2201102/STMC071_board/production/bom.csv

Designator | Footprint | Quantity | Value | LCSC Part #
C1 | 0603 | 1 | 0.1uF
C2 | 0805 | 1 | 10uF | C96446
C3 | 1206 | 1 | 22uF | C45783
C4 | 0603 | 1 | 100nF | C14663
D1 | SOT-23-3 | 1 | CH213K
D2, D3, D4, D5, D6, D7 | LED_WS2812B_PLCC4_5.0x5.0mm_P3.2mm | 6 | WS2812B
D8 | 0805 | 1 | LED_Y | C2296
J1 | U2CF8PA_USB_C | 1 | USB_C_Receptacle_USB2.0_14P
J2 | PinHeader_1x04_P2.54mm_Vertical | 1 | Conn_01x04_Pin
J3, J4 | PinHeader_1x10_P2.54mm_Vertical | 2 | Conn_01x10_Pin
R1, R2 | R_Axial_DIN0207_L6.3mm_D2.5mm_P7.62mm_Horizontal | 2 | 5.1k | C23186
R3 | 0603 | 1 | 1k | C22787
R4 | 0603 | 1 | 10k | C25804
SW1, SW2, SW3 | TS3315 | 3 | SW_Push | C720477
U2 | TSSOP-20_4.4x6.5mm_P0.65mm | 1 | STM32C071F8Px
U3 | SOT-23-3 | 1 | SLHT33H | MCP1700T-3302E/TT
