2201102/STMC071_board/STM32C071.kicad_pcb

## KiCad design STM32C071.kicad_pcb (2026-09-05)

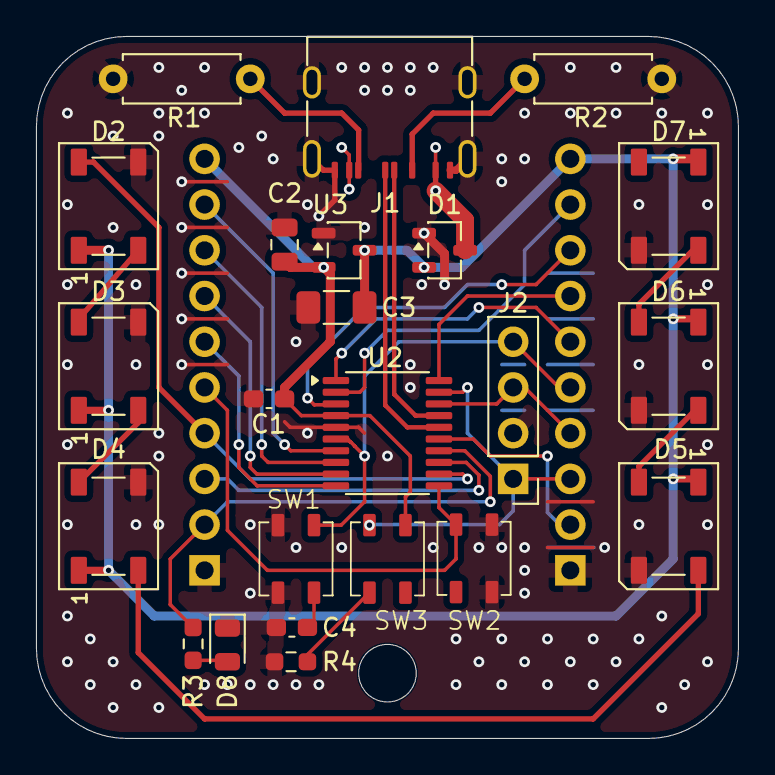
[picture p5: board STM32C071.kicad_pcb from above]

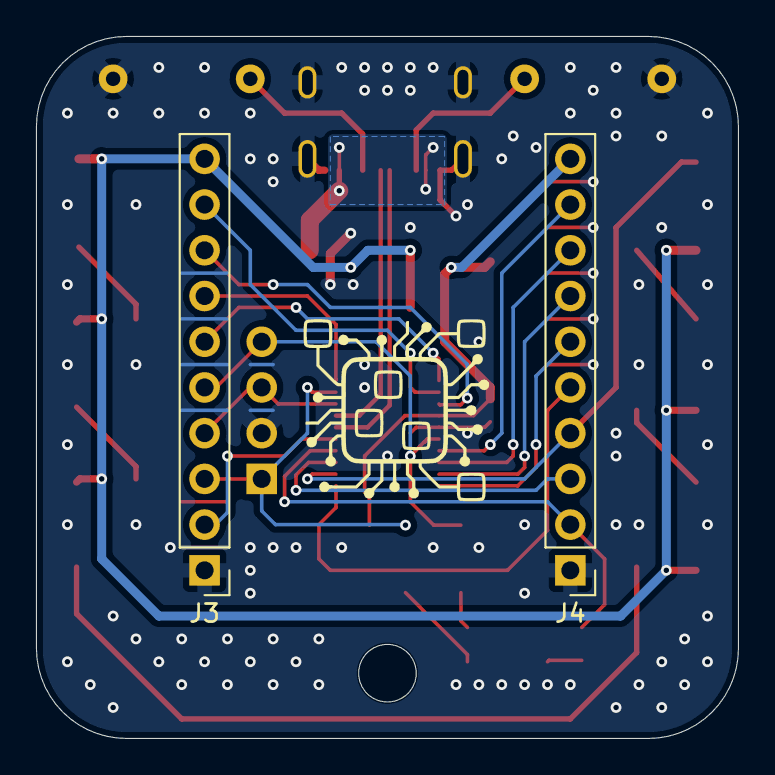
[picture p6: board STM32C071.kicad_pcb from below]

Board: 2 copper layers, 39.0 x 39.0 mm, 26 parts (2 on the bottom side), 30 nets.

Parts:
C1: 0.1uF; C_0603_1608Metric_Pad1.08x0.95mm_HandSolder
C2: 10uF; C_0805_2012Metric
C3: 22uF; C_1206_3216Metric_Pad1.33x1.80mm_HandSolder
C4: 100nF; C_0603_1608Metric_Pad1.08x0.95mm_HandSolder
D1: CH213K; SOT-23-3
D2, D3, D4, D5, D6, D7: WS2812B; LED_WS2812B_PLCC4_5.0x5.0mm_P3.2mm
D8: LED_Y; LED_0805_2012Metric
H1: MountingHole; MountingHole_3.2mm_M3
J1: USB_C_Receptacle_USB2.0_14P; U2CF8PA_USB_C
J2: Conn_01x04_Pin; PinHeader_1x04_P2.54mm_Vertical
J3, J4: Conn_01x10_Pin; PinHeader_1x10_P2.54mm_Vertical
R1, R2: 5.1k; R_Axial_DIN0207_L6.3mm_D2.5mm_P7.62mm_Horizontal
R3: 1k; R_0603_1608Metric_Pad0.98x0.95mm_HandSolder
R4: 10k; R_0603_1608Metric_Pad0.98x0.95mm_HandSolder
SW1, SW2, SW3: SW_Push; TS3315
U2: STM32C071F8Px; TSSOP-20_4.4x6.5mm_P0.65mm
U3: SLHT33H; SOT-23-3

Connections:
+3V3: C1.1, C2.1, J4.10, SW3.1, U2.4 (VDD), U3.2 (OUT)
+5V: C3.1, D1.2 (VO-), D2.1 (VDD), D3.1 (VDD), D4.1 (VDD), D5.1 (VDD), D6.1 (VDD), D7.1 (VDD), J3.10, U3.3 (IN)
/PA0: J4.9, U2.7 (PA0)
/PA1: J4.8, U2.8 (PA1)
/PA2: J4.7, U2.9 (PA2)
/PA3: J4.6, U2.10 (PA3)
/PA6: J4.3, U2.13 (PA6)
/PA8: J3.2, U2.15 (PA8)
/PB3/PB4/PB5/PB6: J3.7, U2.20 (PB3/PB4/PB5/PB6)
/PB7/PB8: J3.6, U2.1 (PB7/PB8)
/PC14: J3.9, U2.2 (PC14)
/PC15: J3.8, U2.3 (PC15)
GND: C1.2, C2.2, C3.2, C4.2, D1.1 (GND), D2.3 (VSS), D3.3 (VSS), D4.3 (VSS), D5.3 (VSS), D6.3 (VSS), D7.3 (VSS), D8.1 (K), J1.A12 (GND), J1.B12 (GND), J1.SH (SHIELD), J2.2, J3.1, J4.1, R1.1, R2.1, R4.2, SW1.2, SW2.2, U2.5 (VSS), U3.1 (GND)
NRST: C4.1, J2.4, J3.5, SW1.1, U2.6 (PF2)
Neopixel: D2.4 (DIN), J4.4, U2.12 (PA5)
unnamed: D1.3 (VI+), J1.A9 (VBUS), J1.B9 (VBUS)
unnamed: D2.2 (DOUT), D3.4 (DIN)
unnamed: D3.2 (DOUT), D4.4 (DIN)
unnamed: D4.2 (DOUT), D5.4 (DIN)
unnamed: D5.2 (DOUT), D6.4 (DIN)
unnamed: D6.2 (DOUT), D7.4 (DIN)
unnamed: D8.2 (A), R3.2
unnamed: J1.A5 (CC1), R2.2
unnamed: J1.B5 (CC2), R1.2
T_SWCLK: J2.1, J3.3, R4.1, SW3.2, U2.19 (PA14/PA15)
T_SWDIO: J2.3, J3.4, U2.18 (PA13)
USB_D+: J1.A6 (D+), U2.17 (PA12)
USB_D-: J1.A7 (D-), U2.16 (PA11)
USER_BUTTON: J4.5, SW2.1, U2.11 (PA4)
USER_LED: J4.2, R3.1, U2.14 (PA7)
