2201102/STMC071_board/sample_program/C071_USBX_CDC/C071_USBX_CDC.ioc

Mcu.UserName=STM32C071F8Px
PA4.GPIO_Label=button
PA4.Signal=GPIO_Input
PA5.Signal=S_TIM1_CH1
