2201102/STMC071_board/(commit log)

2026-09-05 データをアップロード
    [STM32C071.kicad_pcb, STM32C071.kicad_sch, bom.csv, designators.csv, positions.csv]
2026-10-30 写真を追加
2026-10-30 回路図を追加
2026-10-30 説明を追記
