2201102/STMC071_board/(notices)

Notices in the files:
sample_program/C071_USBX_CDC/Core/Src/main.c:
Copyright (c) 2026 STMicroelectronics.
All rights reserved.
This software is licensed under terms that can be found in the LICENSE file
